ronan-39/RGBox/README.md

# RGBox
 Slim hitbox styled fighting game controller based on the RP2040 microcontroller. Laser cut acyrlic case with 3D printed keycaps for Kailh low profile mechanical switches.

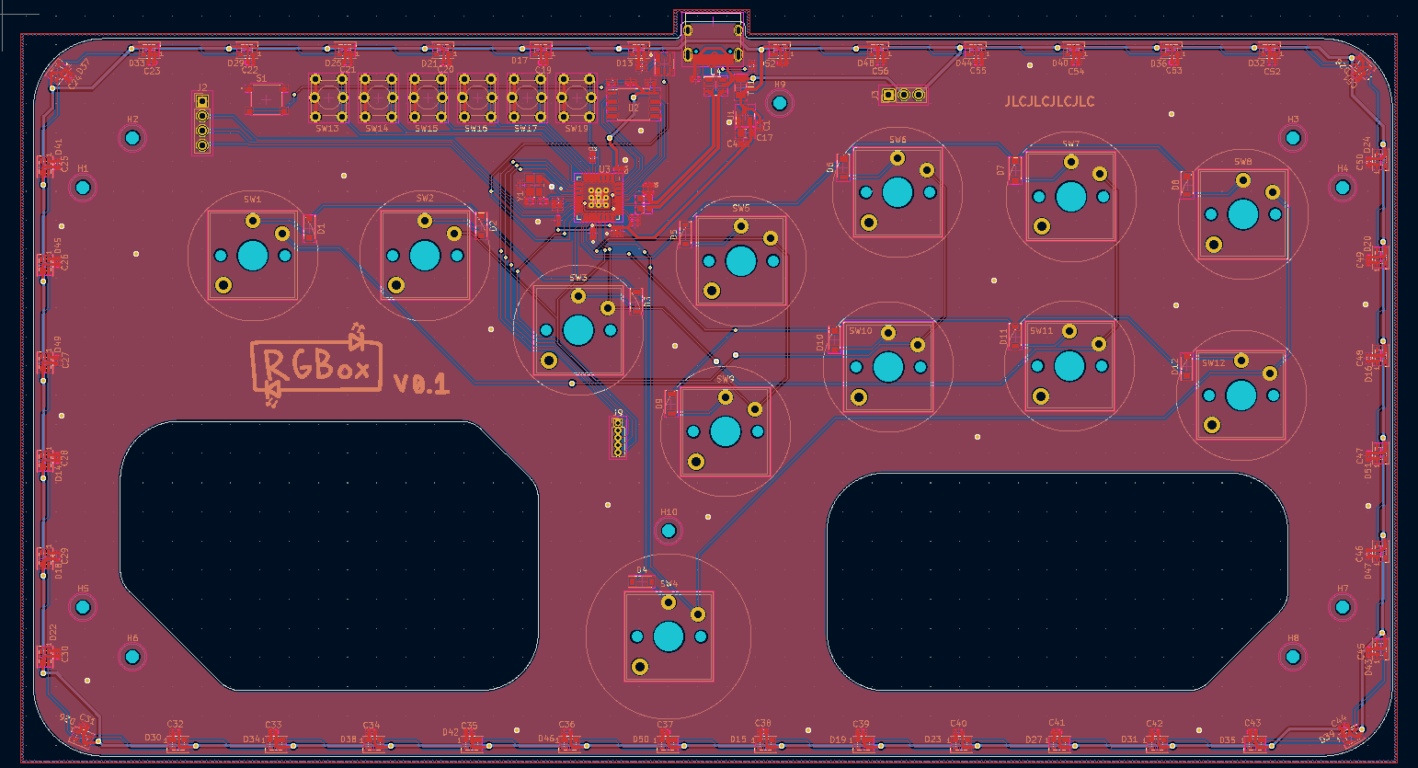
[picture p1: layout_screenshot.png]
layout screenshot

completed device
