ronan-39/RGBox/jlcpcb/production_files_V0.1.3_cutouts/BOM-rgbox.csv

Comment | Designator | Footprint | LCSC
1k | R1,R5 | C_0402_1005Metric | C11702
100nF | C11,C12,C13,C14,C15,C16,C18,C19,C20,C21,C22,C23,C24,C25,C26,C27,C28,C29,C30,C31,C32,C33,C34,C35,C36,C37,C38,C39,C40,C41,C42,C43,C44,C45,C46,C47,C48,C49,C5,C50,C51,C52,C53,C54,C55,C56,C57,C58,C6,C7,C9 | C_0402_1005Metric | C1525
22pF | C2,C3 | C_0402_1005Metric | C1555
10uF | C17 | C_0805_2012Metric | C15850
USB_C_Receptacle_USB2.0 | J1 | USB_C_Receptacle_HRO_TYPE-C-31-M-12 | C165948
RP2040 | U3 | RP2040-QFN-56 | C2040
27.4 | R3,R4 | C_0603_1608Metric | C25190
10k | R8 | C_0402_1005Metric | C25744
5.1k | R6,R7 | C_0402_1005Metric | C25905
SK6812 | D13,D14,D15,D16,D17,D18,D19,D20,D21,D22,D23,D24,D25,D26,D27,D28,D29,D30,D31,D32,D33,D34,D35,D36,D37,D38,D39,D40,D41,D42,D43,D44,D45,D46,D47,D48,D49,D50,D51,D52 | LED_SK6805_PLCC4_2.4x2.7mm_P1.3mm | C2909058
TS-1187A-B-A-B | S1 | SW_TS-1187A-B-A-B | C318884
1uF | C1,C10,C4,C8 | C_0402_1005Metric | C52923
XC6206PxxxMR | U1 | SOT-23 | C5446
Thermistor_PTC | TH1 | Fuse_1206_3216Metric | C70076
74AHCT1G125 | U5 | SOT-23-5 | C7484
1N4148 | D1,D10,D11,D12,D2,D3,D4,D5,D6,D7,D8,D9 | D_SOD-123 | C81598
SRV05-4 | U4 | SOT-23-6-routable | C85364
12MHz | Y1 | Crystal_SMD_3225-4Pin_3.2x2.5mm | C9002
W25Q128JVS | U2 | SOIC-8_5.23x5.23mm_P1.27mm | C97521
Conn_01x04 | J2 | PinHeader_1x04_P2.54mm_Vertical
MountingHole | H7 | MountingHole_2.2mm_M2
SW_Push | SW17 | SW_BUTT-2-4
MountingHole | H8 | MountingHole_2.2mm_M2
Conn_01x03 | J3 | PinHeader_1x03_P2.54mm_Vertical
MountingHole | H2 | MountingHole_2.2mm_M2
MountingHole | H4 | MountingHole_2.2mm_M2
MountingHole | H9 | MountingHole_2.2mm_M2
MountingHole | H3 | MountingHole_2.2mm_M2
SW_Push | SW14 | SW_BUTT-2-4
MountingHole | H10 | MountingHole_2.2mm_M2
SW_Push | SW6 | kailh_alternate
SW_Push | SW8 | kailh_alternate
SW_Push | SW7 | kailh_alternate
SW_Push | SW1 | kailh_alternate
SW_Push | SW11 | kailh_alternate
SW_Push | SW15 | SW_BUTT-2-4
SW_Push | SW16 | SW_BUTT-2-4
SW_Push | SW19 | SW_BUTT-2-4
SW_Push | SW2 | kailh_alternate
SW_Push | SW13 | SW_BUTT-2-4
SW_Push | SW9 | kailh_alternate
Conn_01x05 | J9 | PinHeader_1x05_P1.27mm_Vertical
SW_Push | SW3 | kailh_alternate
SW_Push | SW5 | kailh_alternate
MountingHole | H6 | MountingHole_2.2mm_M2
SW_Push | SW4 | kailh_alternate
SW_Push | SW10 | kailh_alternate
MountingHole | H1 | MountingHole_2.2mm_M2
MountingHole | H5 | MountingHole_2.2mm_M2
SW_Push | SW12 | kailh_alternate
