ronan-39/RGBox/components/WS2812-2020.step

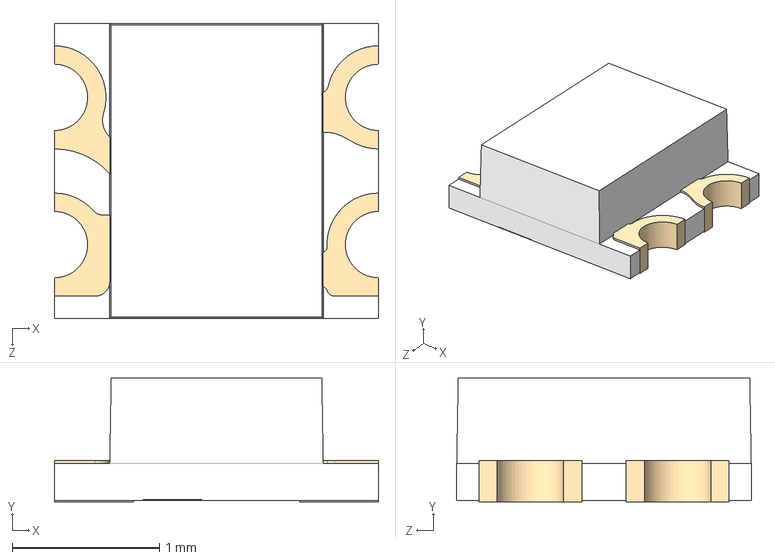
[picture p2: CAD file, 2023-02-26]
components/WS2812-2020.step
2.20 x 0.84 x 2.00 mm
