ronan-39/RGBox/components/TS-1187A-B-A-B.step

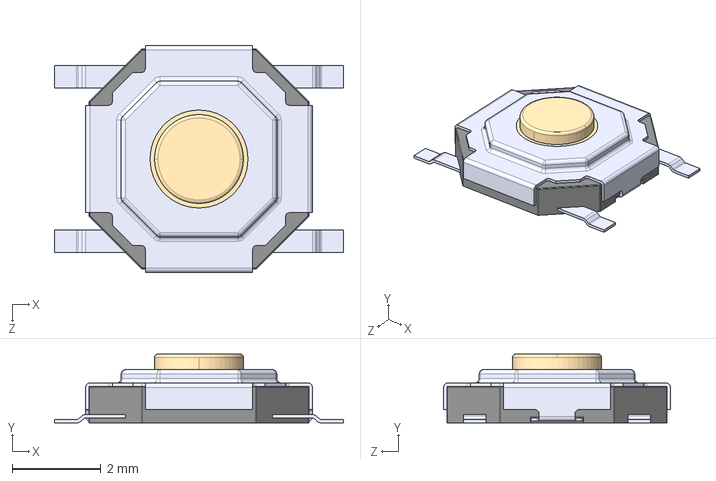
[picture p3: CAD file, 2023-02-26]
components/TS-1187A-B-A-B.step
6.50 x 1.55 x 5.10 mm
