ronan-39/RGBox/layout/pcb_cutouts_v0.2.dxf

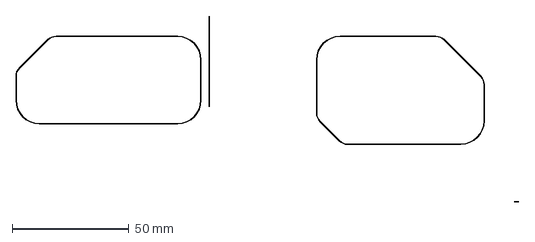
[picture p4: CAD file, 2023-06-17]
layout/pcb_cutouts_v0.2.dxf
215.0 x 79.2 mm
