ronan-39/RGBox/layout/layout_board_combined.dxf

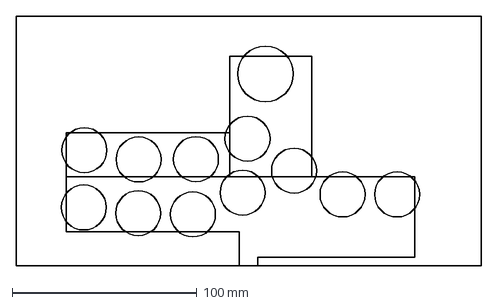
[picture p5: CAD file, 2023-02-26]
layout/layout_board_combined.dxf
252.0 x 135.0 mm
