ronan-39/RGBox/layout/hitbox_layout.dxf

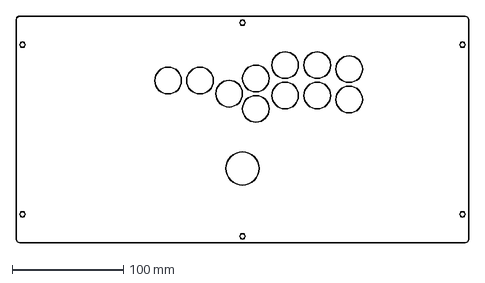
[picture p6: CAD file, 2023-02-26]
layout/hitbox_layout.dxf
406.4 x 203.2 mm
