ronan-39/RGBox/layout/fightstick_v2_layout.dxf

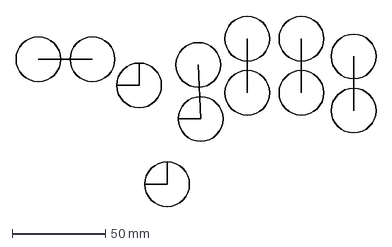
[picture p7: CAD file, 2023-02-26]
layout/fightstick_v2_layout.dxf
193.0 x 102.0 mm
