ronan-39/RGBox/layout/pcb_layout_v0.2.dxf

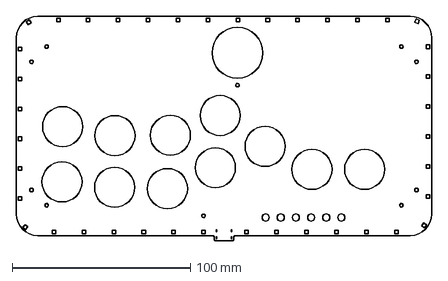
[picture p8: CAD file, 2023-02-26]
layout/pcb_layout_v0.2.dxf
233.0 x 125.8 mm
