ronan-39/RGBox/layout/FINAL_LAYOUT.dxf

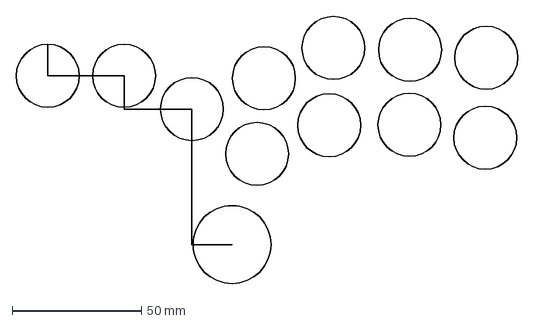
[picture p9: CAD file, 2023-02-26]
layout/FINAL_LAYOUT.dxf
194.2 x 103.4 mm
