ronan-39/RGBox/layout/top_plate_v0.2.dxf

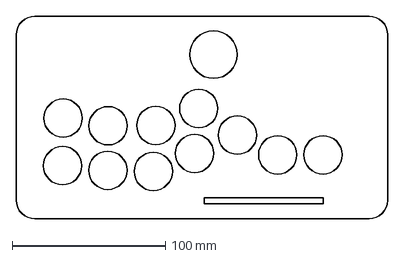
[picture p10: CAD file, 2023-02-26]
layout/top_plate_v0.2.dxf
242.0 x 132.0 mm
