ronan-39/RGBox/layout/pcb_cutouts_v0.1.dxf

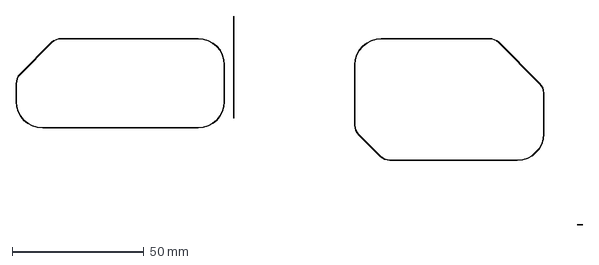
[picture p11: CAD file, 2023-06-17, an earlier design]
layout/pcb_cutouts_v0.1.dxf
215.0 x 79.2 mm
