ronan-39/RGBox/layout/pcb_layout_v0.1.dxf

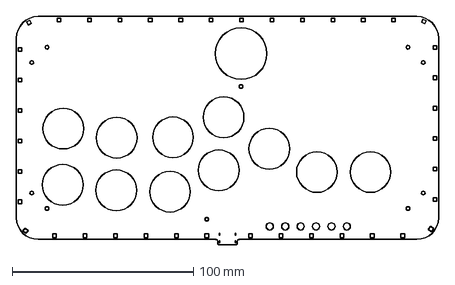
[picture p12: CAD file, 2023-02-26, an earlier design]
layout/pcb_layout_v0.1.dxf
233.0 x 125.8 mm
