ronan-39/RGBox/layout/top_plate_v0.1.dxf

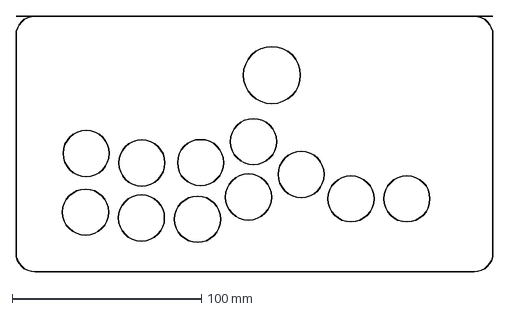
[picture p13: CAD file, 2023-02-26, an earlier design]
layout/top_plate_v0.1.dxf
252.0 x 135.0 mm
