ronan-39/RGBox/fightstick_v2.kicad_pcb

## KiCad design fightstick_v2.kicad_pcb (2023-06-17)

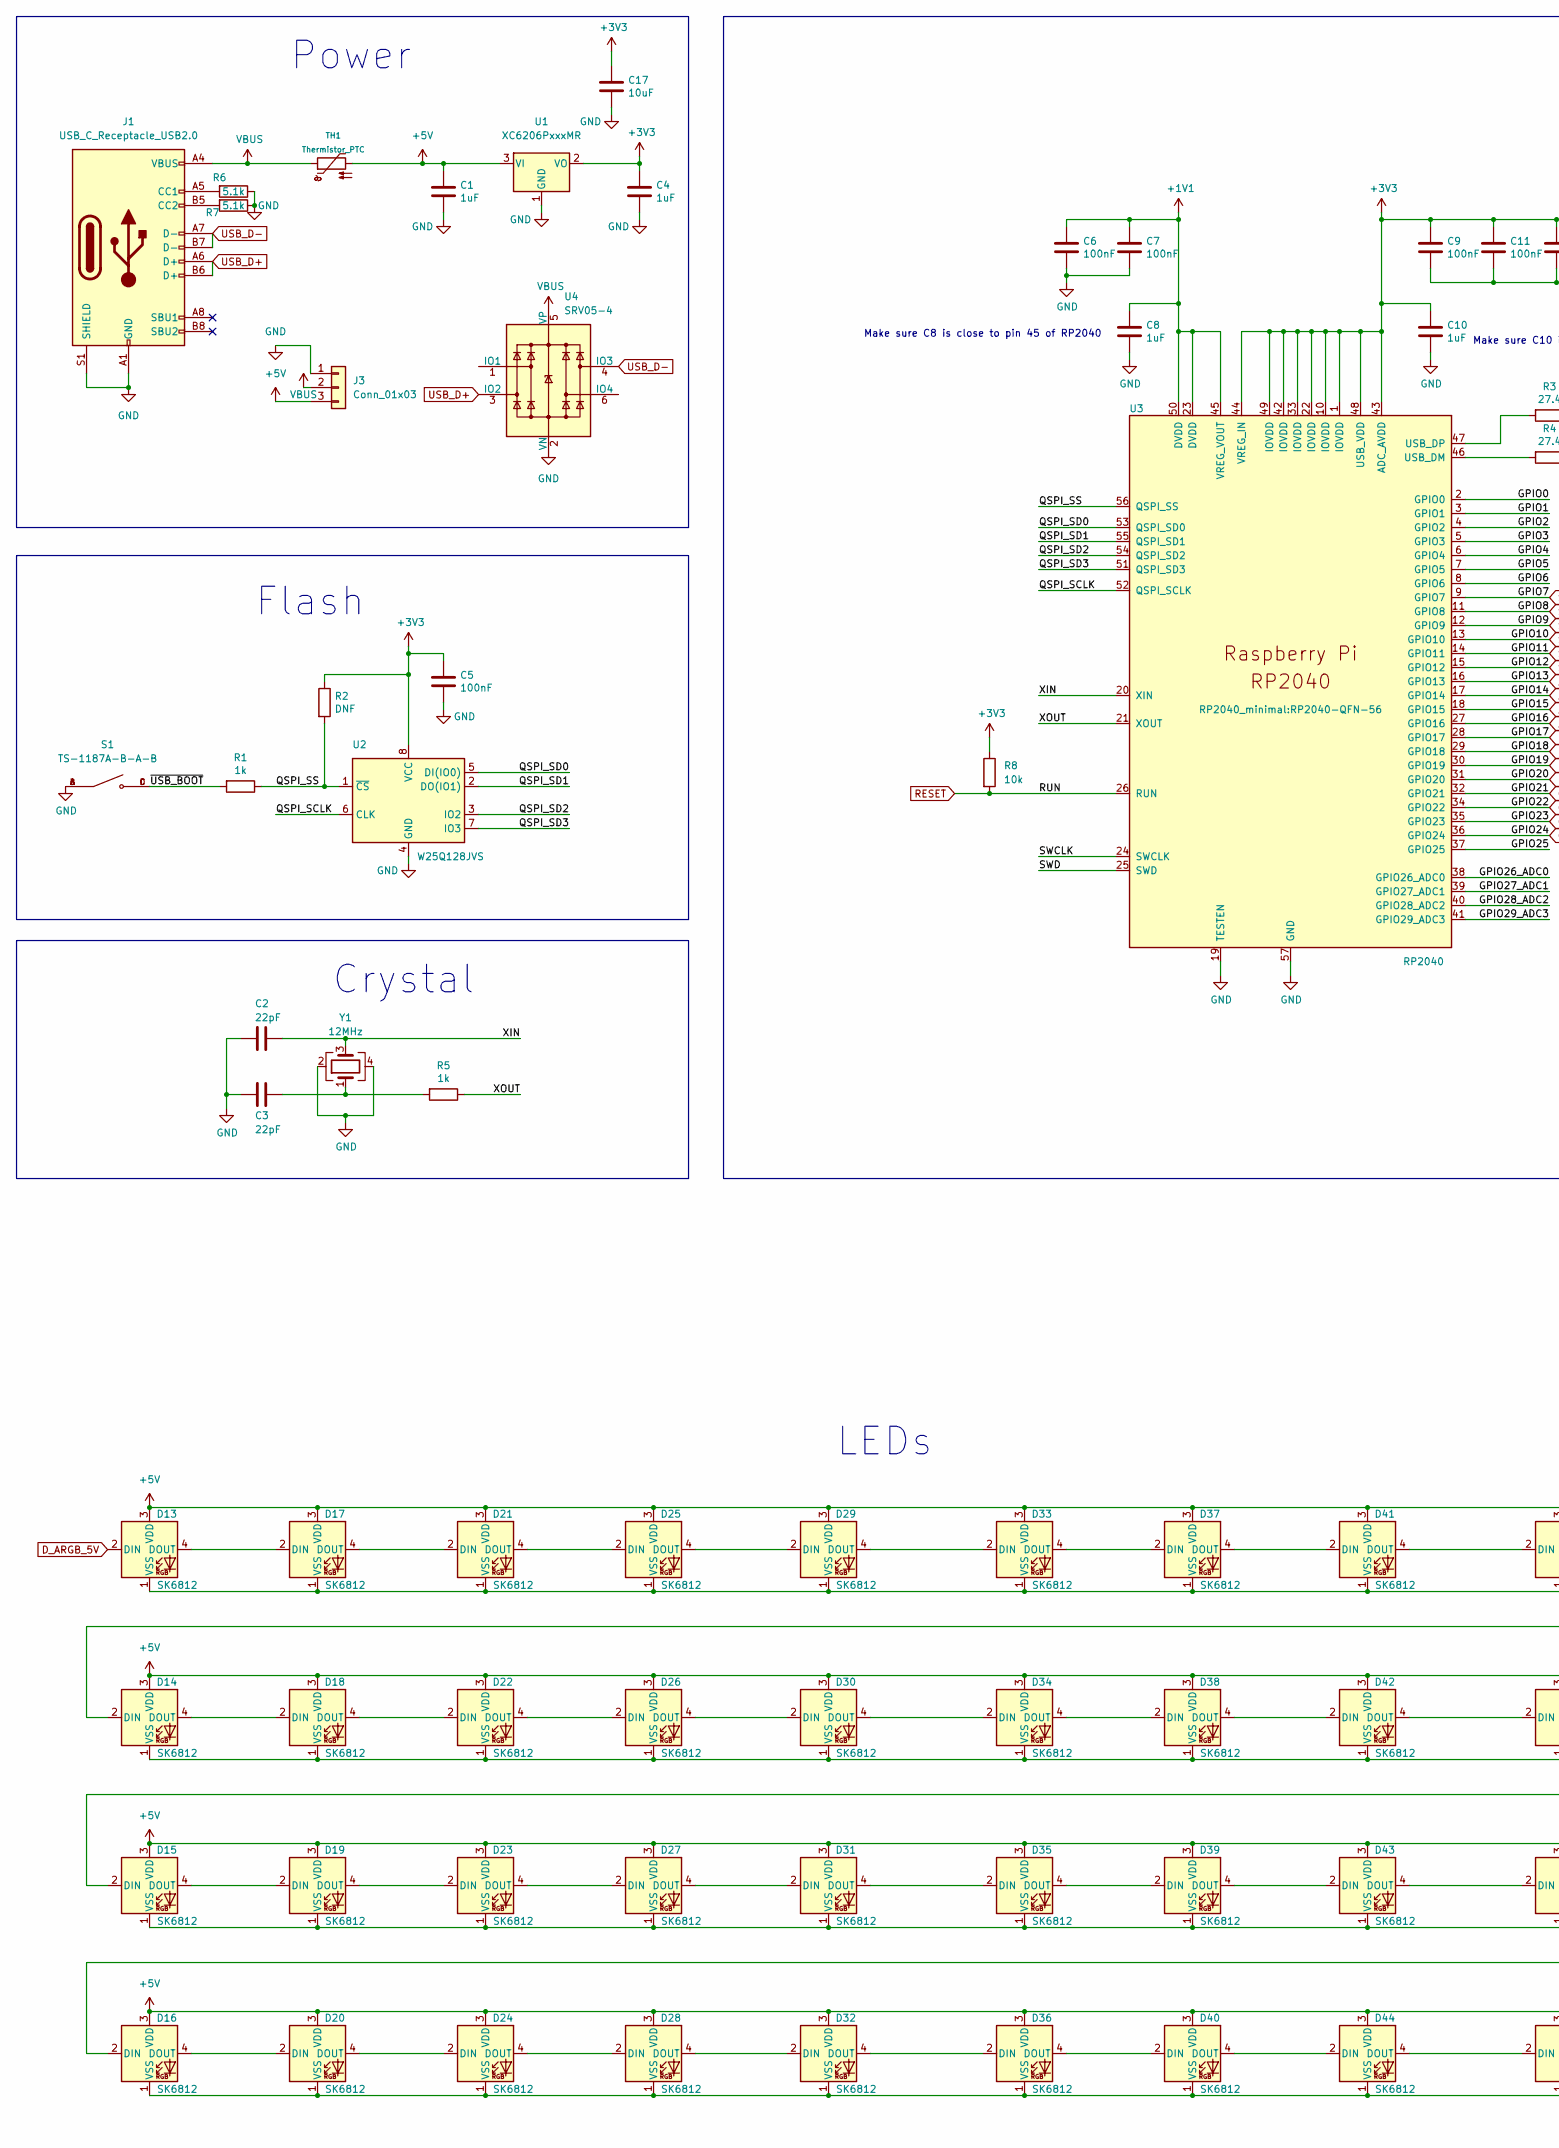
[picture p14: schematic fightstick_v2.kicad_sch, part in row 1, column 1]

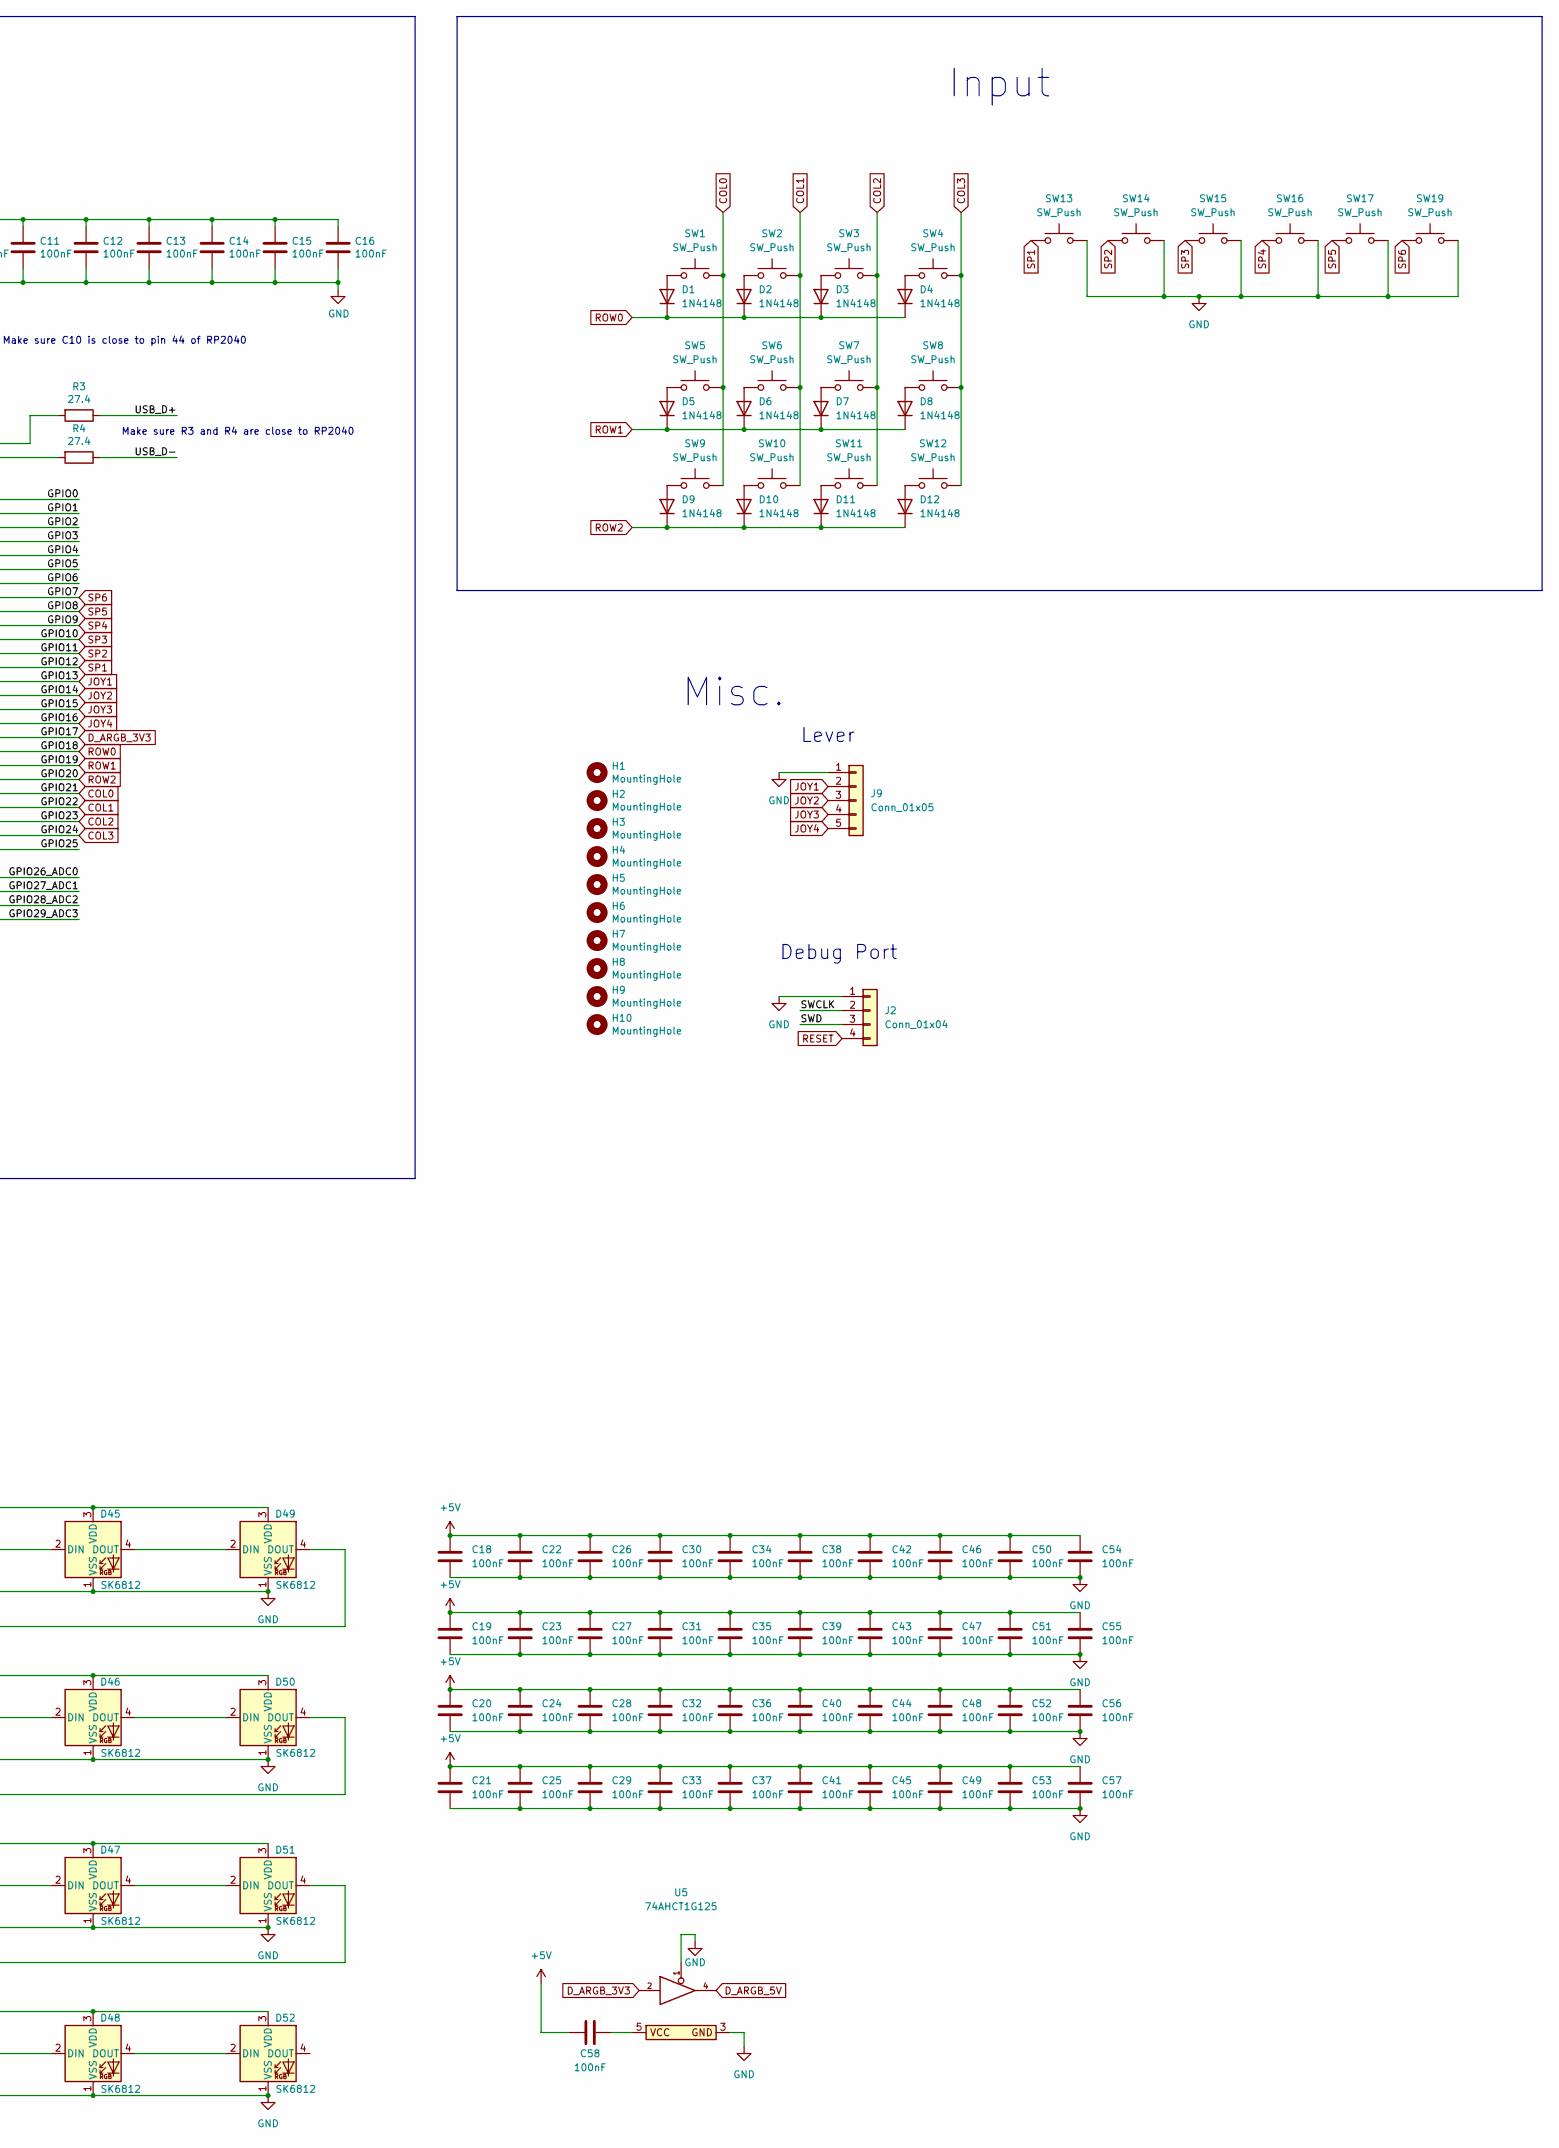
[picture p15: schematic fightstick_v2.kicad_sch, part in row 1, column 2]

Parts:
C1, C4, C8, C10: 1uF; C_0402_1005Metric; LCSC C52923
C2, C3: 22pF; C_0402_1005Metric; LCSC C1555
C5, C6, C7, C9, C11, C12, C13, C14, C15, C16, C18, C19, C20, C21, C22, C23, C24, C25, C26, C27, C28, C29, C30, C31, C32, C33, C34, C35, C36, C37, C38, C39, C40, C41, C42, C43, C44, C45, C46, C47, C48, C49, C50, C51, C52, C53, C54, C55, C56, C57, C58: 100nF; C_0402_1005Metric; LCSC C1525
C17: 10uF; C_0805_2012Metric; LCSC C15850
D1, D2, D3, D4, D5, D6, D7, D8, D9, D10, D11, D12: 1N4148; D_SOD-123; LCSC C81598
D13, D14, D15, D16, D17, D18, D19, D20, D21, D22, D23, D24, D25, D26, D27, D28, D29, D30, D31, D32, D33, D34, D35, D36, D37, D38, D39, D40, D41, D42, D43, D44, D45, D46, D47, D48, D49, D50, D51, D52: SK6812; LED_SK6805_PLCC4_2.4x2.7mm_P1.3mm; LCSC C2909058
H1, H2, H3, H4, H5, H6, H7, H8, H9, H10: MountingHole; MountingHole_2.2mm_M2
J1: USB_C_Receptacle_USB2.0; USB_C_Receptacle_HRO_TYPE-C-31-M-12; LCSC C165948
J2: Conn_01x04; PinHeader_1x04_P2.54mm_Vertical
J3: Conn_01x03; PinHeader_1x03_P2.54mm_Vertical
J9: Conn_01x05; PinHeader_1x05_P1.27mm_Vertical
R1, R5: 1k; C_0402_1005Metric; LCSC C11702
R2: DNF; C_0402_1005Metric
R3, R4: 27.4; C_0603_1608Metric; LCSC C25190
R6, R7: 5.1k; C_0402_1005Metric; LCSC C25905
R8: 10k; C_0402_1005Metric; LCSC C25744
S1: TS-1187A-B-A-B; SW_TS-1187A-B-A-B; PARTREV A0; LCSC C318884
SW1, SW2, SW3, SW4, SW5, SW6, SW7, SW8, SW9, SW10, SW11, SW12: SW_Push; kailh_alternate
SW13, SW14, SW15, SW16, SW17, SW19: SW_Push; SW_BUTT-2-4
TH1: Thermistor_PTC; Fuse_1206_3216Metric; LCSC C70076
U1: XC6206PxxxMR; SOT-23; LCSC C5446
U2: W25Q128JVS; SOIC-8_5.23x5.23mm_P1.27mm; LCSC C97521
U3: RP2040; RP2040-QFN-56; LCSC C2040
U4: SRV05-4; SOT-23-6-routable; LCSC C85364
U5: 74AHCT1G125; SOT-23-5; LCSC C7484
Y1: 12MHz; Crystal_SMD_3225-4Pin_3.2x2.5mm; LCSC C9002

Connections:
+1V1: C6.1, C7.1, C8.1, U3.23 (DVDD), U3.45 (VREG_VOUT), U3.50 (DVDD)
+3V3: C4.1, C5.1, C9.1, C10.1, C11.1, C12.1, C13.1, C14.1, C15.1, C16.1, C17.1, R2.1, R8.1, U1.2 (VO), U2.8 (VCC), U3.1 (IOVDD), U3.10 (IOVDD), U3.22 (IOVDD), U3.33 (IOVDD), U3.42 (IOVDD), U3.43 (ADC_AVDD), U3.44 (VREG_IN), U3.48 (USB_VDD), U3.49 (IOVDD)
+5V: C1.1, C18.1, C19.1, C20.1, C21.1, C22.1, C23.1, C24.1, C25.1, C26.1, C27.1, C28.1, C29.1, C30.1, C31.1, C32.1, C33.1, C34.1, C35.1, C36.1, C37.1, C38.1, C39.1, C40.1, C41.1, C42.1, C43.1, C44.1, C45.1, C46.1, C47.1, C48.1, C49.1, C50.1, C51.1, C52.1, C53.1, C54.1, C55.1, C56.1, C57.1, C58.2, D13.3 (VDD), D14.3 (VDD), D15.3 (VDD), D16.3 (VDD), D17.3 (VDD), D18.3 (VDD), D19.3 (VDD), D20.3 (VDD), D21.3 (VDD), D22.3 (VDD), D23.3 (VDD), D24.3 (VDD), D25.3 (VDD), D26.3 (VDD), D27.3 (VDD), D28.3 (VDD), D29.3 (VDD), D30.3 (VDD), D31.3 (VDD), D32.3 (VDD), D33.3 (VDD), D34.3 (VDD), D35.3 (VDD), D36.3 (VDD), D37.3 (VDD), D38.3 (VDD), D39.3 (VDD), D40.3 (VDD), D41.3 (VDD), D42.3 (VDD), D43.3 (VDD), D44.3 (VDD), D45.3 (VDD), D46.3 (VDD), D47.3 (VDD), D48.3 (VDD), D49.3 (VDD), D50.3 (VDD), D51.3 (VDD), D52.3 (VDD), J3.3, TH1.2, U1.3 (VI)
/GPIO0: U3.2 (GPIO0)
/GPIO1: U3.3 (GPIO1)
/GPIO2: U3.4 (GPIO2)
/GPIO3: U3.5 (GPIO3)
/GPIO4: U3.6 (GPIO4)
/GPIO5: U3.7 (GPIO5)
/GPIO6: U3.8 (GPIO6)
/GPIO25: U3.37 (GPIO25)
/GPIO26_ADC0: U3.38 (GPIO26_ADC0)
/GPIO27_ADC1: U3.39 (GPIO27_ADC1)
/GPIO28_ADC2: U3.40 (GPIO28_ADC2)
/GPIO29_ADC3: U3.41 (GPIO29_ADC3)
/QSPI_SCLK: U2.6 (CLK), U3.52 (QSPI_SCLK)
/QSPI_SD0: U2.5 (DI(IO0)), U3.53 (QSPI_SD0)
/QSPI_SD1: U2.2 (DO(IO1)), U3.55 (QSPI_SD1)
/QSPI_SD2: U2.3 (IO2), U3.54 (QSPI_SD2)
/QSPI_SD3: U2.7 (IO3), U3.51 (QSPI_SD3)
/QSPI_SS: R1.1, R2.2, U2.1 (~CS), U3.56 (QSPI_SS)
/SWCLK: J2.2, U3.24 (SWCLK)
/SWD: J2.3, U3.25 (SWD)
/XIN: C2.1, U3.20 (XIN), Y1.3
/XOUT: R5.1, U3.21 (XOUT)
/~USB_BOOT: R1.2, S1.C, S1.D
COL0: SW1.2, SW5.2, SW9.2, U3.32 (GPIO21)
COL1: SW2.2, SW6.2, SW10.2, U3.34 (GPIO22)
COL2: SW3.2, SW7.2, SW11.2, U3.35 (GPIO23)
COL3: SW4.2, SW8.2, SW12.2, U3.36 (GPIO24)
D_ARGB_3V3: U3.28 (GPIO17), U5.2
D_ARGB_5V: D13.2 (DIN), U5.4
GND: C1.2, C2.2, C3.2, C4.2, C5.2, C6.2, C7.2, C8.2, C9.2, C10.2, C11.2, C12.2, C13.2, C14.2, C15.2, C16.2, C17.2, C18.2, C19.2, C20.2, C21.2, C22.2, C23.2, C24.2, C25.2, C26.2, C27.2, C28.2, C29.2, C30.2, C31.2, C32.2, C33.2, C34.2, C35.2, C36.2, C37.2, C38.2, C39.2, C40.2, C41.2, C42.2, C43.2, C44.2, C45.2, C46.2, C47.2, C48.2, C49.2, C50.2, C51.2, C52.2, C53.2, C54.2, C55.2, C56.2, C57.2, D13.1 (VSS), D14.1 (VSS), D15.1 (VSS), D16.1 (VSS), D17.1 (VSS), D18.1 (VSS), D19.1 (VSS), D20.1 (VSS), D21.1 (VSS), D22.1 (VSS), D23.1 (VSS), D24.1 (VSS), D25.1 (VSS), D26.1 (VSS), D27.1 (VSS), D28.1 (VSS), D29.1 (VSS), D30.1 (VSS), D31.1 (VSS), D32.1 (VSS), D33.1 (VSS), D34.1 (VSS), D35.1 (VSS), D36.1 (VSS), D37.1 (VSS), D38.1 (VSS), D39.1 (VSS), D40.1 (VSS), D41.1 (VSS), D42.1 (VSS), D43.1 (VSS), D44.1 (VSS), D45.1 (VSS), D46.1 (VSS), D47.1 (VSS), D48.1 (VSS), D49.1 (VSS), D50.1 (VSS), D51.1 (VSS), D52.1 (VSS), J1.A1 (GND), J1.A12 (GND), J1.B1 (GND), J1.B12 (GND), J1.S1 (SHIELD), J2.1, J3.1, J9.1, R6.1, R7.1, S1.A, S1.B, SW13.2, SW14.2, SW15.2, SW16.2, SW17.2, SW19.2, U1.1 (GND), U2.4 (GND), U3.19 (TESTEN), U3.57 (GND), U4.2 (VN), U5.1, U5.3 (GND), Y1.2, Y1.4
JOY1: J9.2, U3.16 (GPIO13)
JOY2: J9.3, U3.17 (GPIO14)
JOY3: J9.4, U3.18 (GPIO15)
JOY4: J9.5, U3.27 (GPIO16)
unnamed: C3.1, R5.2, Y1.1
unnamed: C58.1, U5.5
unnamed: D1.2 (A), SW1.1
unnamed: D2.2 (A), SW2.1
unnamed: D3.2 (A), SW3.1
unnamed: D4.2 (A), SW4.1
unnamed: D5.2 (A), SW5.1
unnamed: D6.2 (A), SW6.1
unnamed: D7.2 (A), SW7.1
unnamed: D8.2 (A), SW8.1
unnamed: D9.2 (A), SW9.1
unnamed: D10.2 (A), SW10.1
unnamed: D11.2 (A), SW11.1
unnamed: D12.2 (A), SW12.1
unnamed: D13.4 (DOUT), D17.2 (DIN)
unnamed: D14.2 (DIN), D49.4 (DOUT)
unnamed: D14.4 (DOUT), D18.2 (DIN)
unnamed: D15.2 (DIN), D50.4 (DOUT)
unnamed: D15.4 (DOUT), D19.2 (DIN)
unnamed: D16.2 (DIN), D51.4 (DOUT)
unnamed: D16.4 (DOUT), D20.2 (DIN)
unnamed: D17.4 (DOUT), D21.2 (DIN)
unnamed: D18.4 (DOUT), D22.2 (DIN)
unnamed: D19.4 (DOUT), D23.2 (DIN)
unnamed: D20.4 (DOUT), D24.2 (DIN)
unnamed: D21.4 (DOUT), D25.2 (DIN)
unnamed: D22.4 (DOUT), D26.2 (DIN)
unnamed: D23.4 (DOUT), D27.2 (DIN)
unnamed: D24.4 (DOUT), D28.2 (DIN)
unnamed: D25.4 (DOUT), D29.2 (DIN)
unnamed: D26.4 (DOUT), D30.2 (DIN)
unnamed: D27.4 (DOUT), D31.2 (DIN)
unnamed: D28.4 (DOUT), D32.2 (DIN)
unnamed: D29.4 (DOUT), D33.2 (DIN)
unnamed: D30.4 (DOUT), D34.2 (DIN)
unnamed: D31.4 (DOUT), D35.2 (DIN)
unnamed: D32.4 (DOUT), D36.2 (DIN)
unnamed: D33.4 (DOUT), D37.2 (DIN)
unnamed: D34.4 (DOUT), D38.2 (DIN)
unnamed: D35.4 (DOUT), D39.2 (DIN)
unnamed: D36.4 (DOUT), D40.2 (DIN)
unnamed: D37.4 (DOUT), D41.2 (DIN)
unnamed: D38.4 (DOUT), D42.2 (DIN)
unnamed: D39.4 (DOUT), D43.2 (DIN)
unnamed: D40.4 (DOUT), D44.2 (DIN)
unnamed: D41.4 (DOUT), D45.2 (DIN)
unnamed: D42.4 (DOUT), D46.2 (DIN)
unnamed: D43.4 (DOUT), D47.2 (DIN)
unnamed: D44.4 (DOUT), D48.2 (DIN)
unnamed: D45.4 (DOUT), D49.2 (DIN)
unnamed: D46.4 (DOUT), D50.2 (DIN)
unnamed: D47.4 (DOUT), D51.2 (DIN)
unnamed: D48.4 (DOUT), D52.2 (DIN)
unnamed: J1.A5 (CC1), R6.2
unnamed: J1.B5 (CC2), R7.2
unnamed: R3.2, U3.47 (USB_DP)
unnamed: R4.2, U3.46 (USB_DM)
RESET: J2.4, R8.2, U3.26 (RUN)
ROW0: D1.1 (K), D2.1 (K), D3.1 (K), D4.1 (K), U3.29 (GPIO18)
ROW1: D5.1 (K), D6.1 (K), D7.1 (K), D8.1 (K), U3.30 (GPIO19)
ROW2: D9.1 (K), D10.1 (K), D11.1 (K), D12.1 (K), U3.31 (GPIO20)
SP1: SW13.1, U3.15 (GPIO12)
SP2: SW14.1, U3.14 (GPIO11)
SP3: SW15.1, U3.13 (GPIO10)
SP4: SW16.1, U3.12 (GPIO9)
SP5: SW17.1, U3.11 (GPIO8)
SP6: SW19.1, U3.9 (GPIO7)
USB_D+: J1.A6 (D+), J1.B6 (D+), R3.1, U4.3 (IO2)
USB_D-: J1.A7 (D-), J1.B7 (D-), R4.1, U4.4 (IO3)
VBUS: J1.A4 (VBUS), J1.A9 (VBUS), J1.B4 (VBUS), J1.B9 (VBUS), J3.2, TH1.1, U4.5 (VP)

Notes on the sheet:
Misc.
Crystal
Make sure C8 is close to pin 45 of RP2040
Make sure R3 and R4 are close to RP2040
Flash
Debug Port
Make sure C10 is close to pin 44 of RP2040
LEDs
Lever
Power
Input

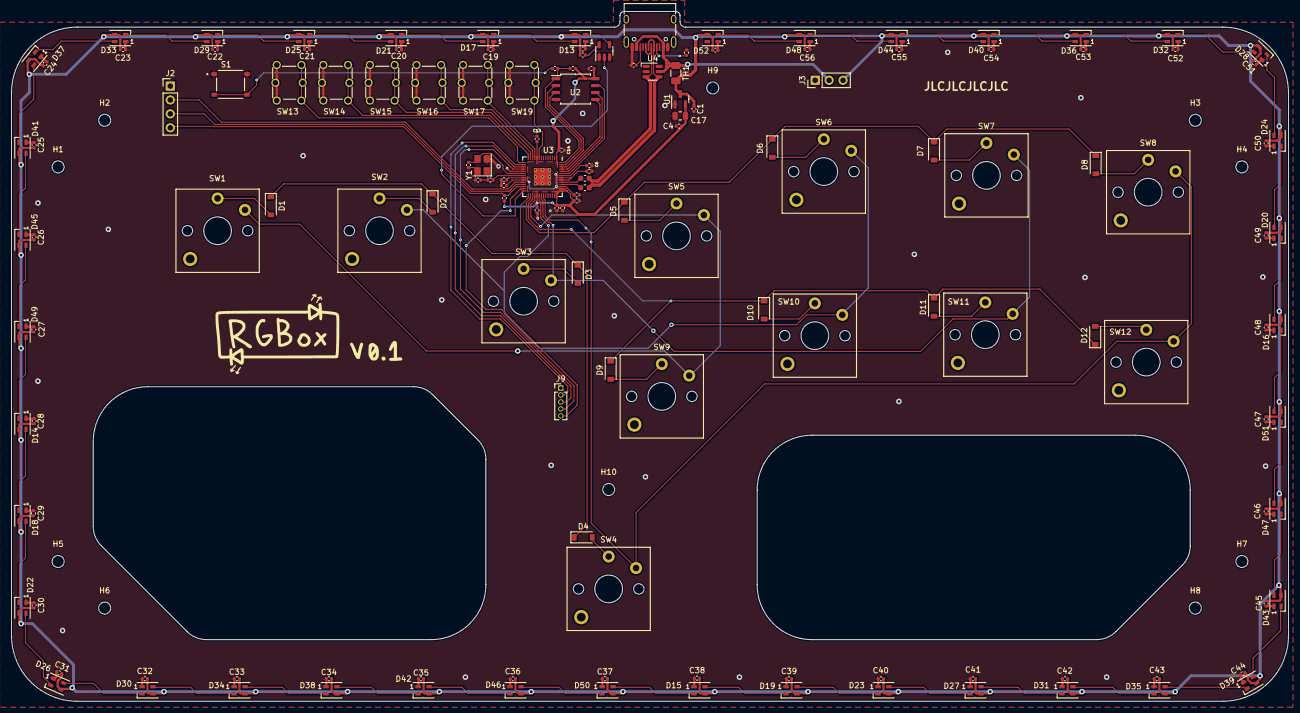
[picture p16: board fightstick_v2.kicad_pcb from above]

Board: 2 copper layers, 233.0 x 125.9 mm, 158 parts (0 on the bottom side), 95 nets.
