ronan-39/RGBox/(commit log)

2023-02-26 Fixed Repo
    [FINAL_LAYOUT.dxf, TS-1187A-B-A-B.step, WS2812-2020.step, fightstick_v2.kicad_pcb, fightstick_v2.kicad_sch, fightstick_v2_layout.dxf, hitbox_layout.dxf, layout_board_combined.dxf]
2023-02-26 finished routing and mostly clear DRC
    [fightstick_v2.kicad_pcb]
2023-02-27 fixed everything i can tell is wrong
    [fightstick_v2.kicad_pcb]
2023-02-27 tried creating a bom
    [RGBox_BOM_v0.1.csv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]
2023-02-28 about to try to reroute things
    [fightstick_v2.kicad_pcb]
2023-02-28 v0.1, shipping this
    [RGBox_BOM_v0.1.csv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]
2023-03-01 replaced leds with sk6812-ec20s
    [BOM-fightstick_v2.csv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]
2023-03-01 last update for now on sk6812 ver
    these are the files im submitting to jlc. im thinking about making a version with dumb led's which would save me about $10 minimum but that will go on a different branch
    [BOM-fightstick_v2.csv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]
2023-06-17 currrent working hid descriptor
    [BOM-rgbox.csv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]
